Gandra-et-al/NanoLogger/README.md

NanoLogger
==========

A low-cost versatile data logging system for ecological applications

==========

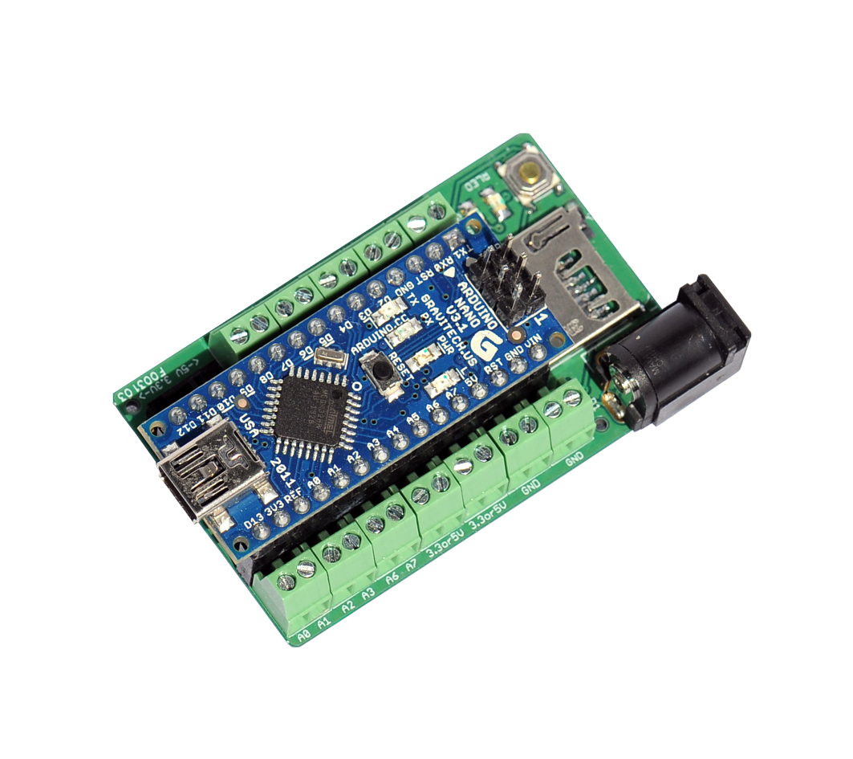
[picture p1: NanoLogger.png]
NanoLogger
