Gandra-et-al/NanoLogger/Software/Settings.txt

Rate = 1
LogDuration = 10
SleepDuration = 10
StartDate = 2014-05-31
StartTime = 16:30
FileThreshold = 10

/// INSTRUCTIONS ///
Rate in Hz, samples/second (up to 3000)
LogDuration in seconds
SleepDuration in seconds
StartDate: (yyyy-mm-dd)
StartTime: (hh:mm, 24 hours format)
FileThreshold - generate a new file after x sampling sessions
