Gandra-et-al/NanoLogger/Hardware/Schematic.pdf

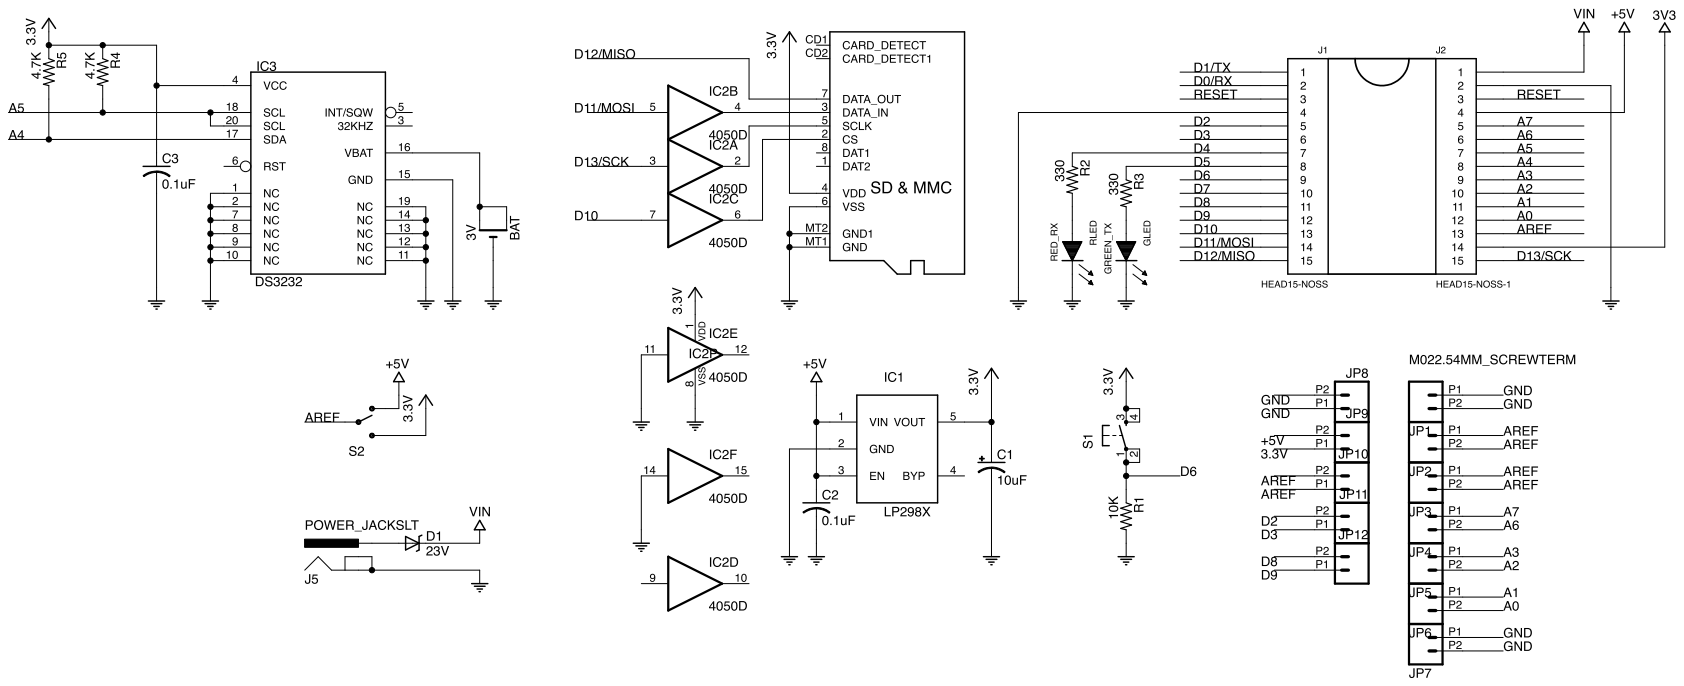
[picture p2: page 1]
