Gandra-et-al/NanoLogger/Hardware/NanoLogger_V2.brd

## EAGLE design Hardware/NanoLogger_V2.brd (2014-05-20)

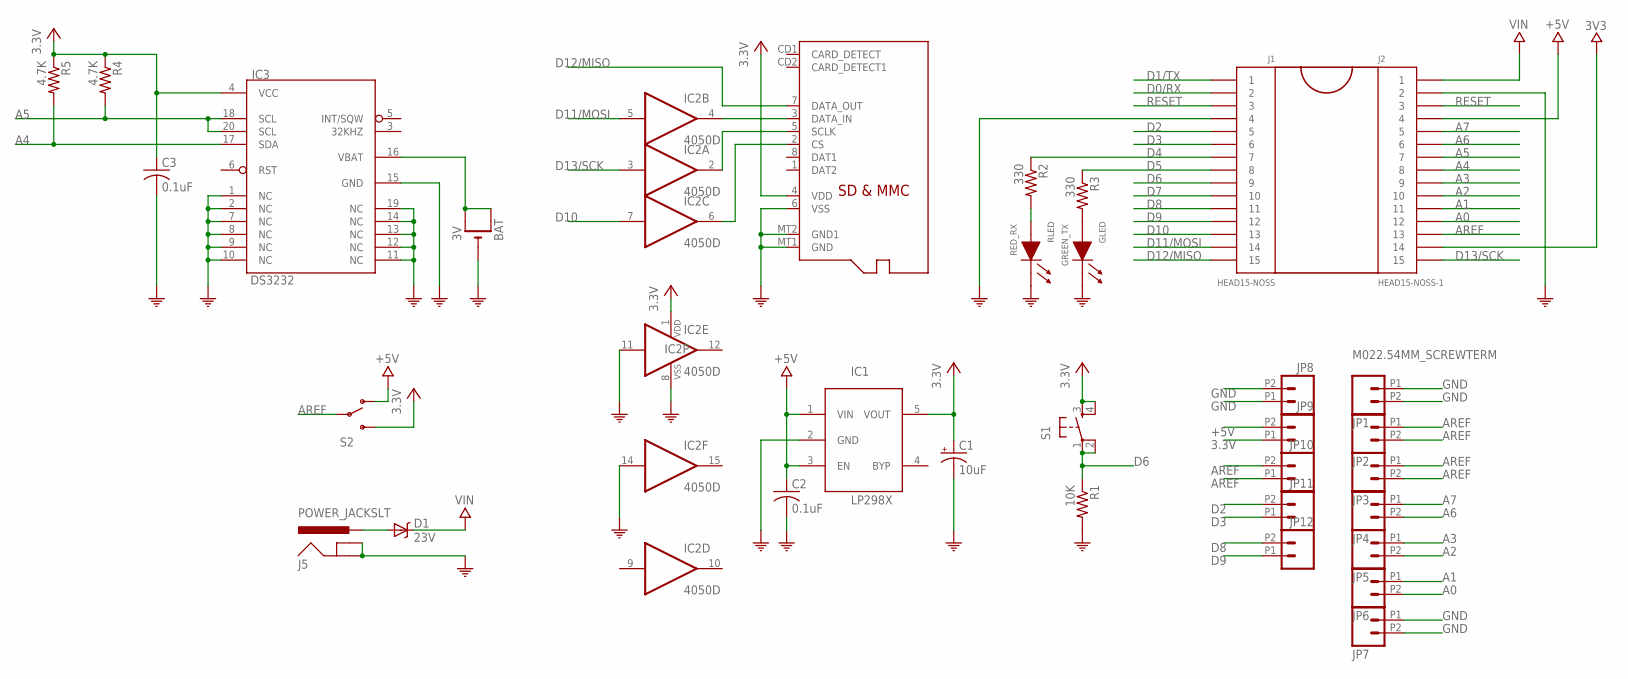
[picture p3: schematic NanoLogger_V2.sch]

Parts:
BAT: 3V; CR1220-SMD
C1: 10uF; A/3216-18R
C2, C3: 0.1uF; C0805K
D1: 23V; SOD-323
GLED: GREEN_TX; LED0805
IC1: LP298XS; SOT23-5L
IC2: 4050D; SO16
IC3: DS3232; SO20L
J1: HEAD15-NOSS
J2: HEAD15-NOSS-1
J5: POWER_JACKSLT; POWER_JACK_SLOT
JP1, JP2, JP3, JP4, JP5, JP6, JP7, JP8, JP9, JP10, JP11, JP12: M022.54MM_SCREWTERM; 1X02_2.54_SCREWTERM
R1: 10K; R0805
R2, R3: 330; R0805
R4, R5: 4.7K; R0805
RLED: RED_RX; LED0805
S1: TAC_SWITCHSMD; TACTILE_SWITCH_SMD
S2: SWITCH-SPDTPTH; SWITCH-SPDT
X1: MICROSD

Connections:
3.3V: C1.+, C3.1, IC1.5 (VOUT), IC2.1 (VDD), IC3.4 (VCC), JP9.P1 (1), R4.1, R5.1, S1.3, S1.4, S2.3 (S), X1.4 (VDD)
3V3: J2.14
+5V: C2.1, IC1.1 (VIN), IC1.3 (EN), J2.4, JP9.P2 (2), S2.1 (O)
A0: J2.12, JP6.P2 (2)
A1: J2.11, JP6.P1 (1)
A2: J2.10, JP5.P2 (2)
A3: J2.9, JP5.P1 (1)
A4: IC3.17 (SDA), J2.8, R5.2
A5: IC3.18 (SCL), IC3.20 (SCL), J2.7, R4.2
A6: J2.6, JP4.P2 (2)
A7: J2.5, JP4.P1 (1)
AREF: J2.13, JP2.P1 (1), JP2.P2 (2), JP3.P1 (1), JP3.P2 (2), JP10.P1 (1), JP10.P2 (2), S2.2
BAT_POWER: D1.2 (A), J5.PWR
D0/RX: J1.2
D1/TX: J1.1
D2: J1.5, JP11.P2 (2)
D3: J1.6, JP11.P1 (1)
D4: J1.7, R2.1
D5: J1.8, R3.1
D6: J1.9, R1.1, S1.1, S1.2
D7: J1.10
D8: J1.11, JP12.P2 (2)
D9: J1.12, JP12.P1 (1)
D10: IC2.7 (I), J1.13
D11/MOSI: IC2.5 (I), J1.14
D12/MISO: J1.15, X1.7 (DATA_OUT)
D13/SCK: IC2.3 (I), J2.15
GND: BAT.-, C1.-, C2.2, C3.2, GLED.1 (CA), IC1.2 (GND), IC2.8 (VSS), IC2.11 (I), IC2.14 (I), IC3.1 (NC), IC3.2 (NC), IC3.7 (NC), IC3.8 (NC), IC3.9 (NC), IC3.10 (NC), IC3.11 (NC), IC3.12 (NC), IC3.13 (NC), IC3.14 (NC), IC3.15 (GND), IC3.19 (NC), J1.4, J2.2, J5.GND@1 (GNDBREAK), J5.GND@2 (GND), JP1.P1 (1), JP1.P2 (2), JP7.P1 (1), JP7.P2 (2), JP8.P1 (1), JP8.P2 (2), R1.2, RLED.1 (CA), X1.6 (VSS), X1.MT1 (GND), X1.MT2 (GND1)
unnamed: IC2.2 (O), X1.5 (SCLK)
unnamed: IC2.6 (O), X1.2 (CS)
unnamed: IC2.4 (O), X1.3 (DATA_IN)
unnamed: GLED.2 (AN), R3.2
unnamed: R2.2, RLED.2 (AN)
RESET: J1.3, J2.3
VBAT: BAT.+$1 (+), BAT.+$2 (+1), IC3.16 (VBAT)
VIN: D1.1 (C), J2.1

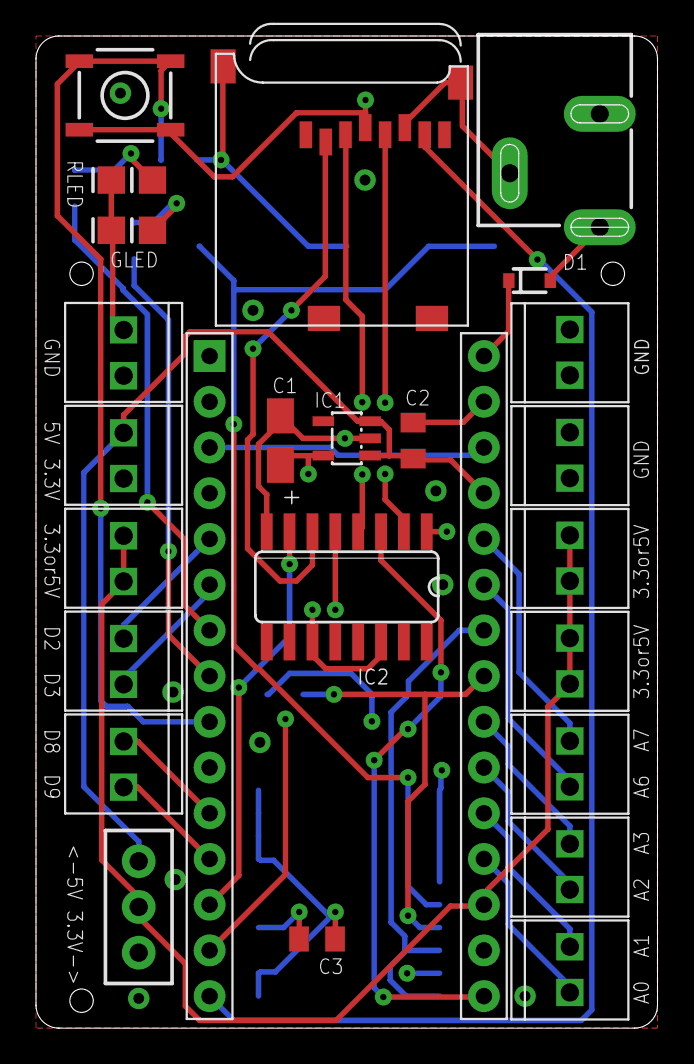
[picture p4: board NanoLogger_V2.brd from above]

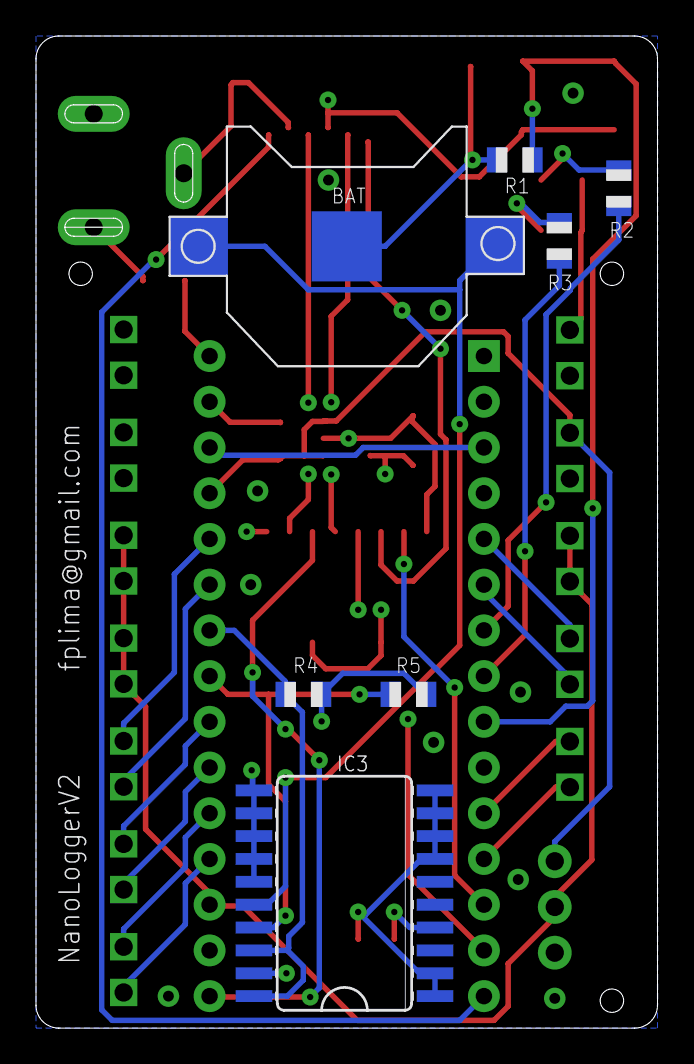
[picture p5: board NanoLogger_V2.brd from below]

Board: 4 copper layers, 34.5 x 55.1 mm, 33 parts (7 on the bottom side), 32 nets.
