Gandra-et-al/NanoLogger/Software/Arduino Libraires/NilRTOS/niltypes.h

/*
    Nil RTOS - Copyright (C) 2012 Giovanni Di Sirio.

    This file is part of Nil RTOS.

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
    You should have received a copy of the GNU General Public License
    along with this program.  If not, see <http://www.gnu.org/licenses/>.
*/

/**
 * @file    niltypes.h
 * @brief   Nil RTOS types header file.
 *
 * @addtogroup AVR_TYPES
 * @{
 */

#ifndef _NILTYPES_H_
#define _NILTYPES_H_

#include <stddef.h>
#include <stdint.h>
#include <stdbool.h>

/**
 * @name Kernel types
 * @{
 */
typedef uint8_t         tstate_t;   /**< @brief Type of a thread state.     */
typedef int16_t         msg_t;      /**< @brief Type of a message.          */
typedef uint16_t        systime_t;  /**< @brief Type of system time.        */
typedef int16_t         cnt_t;      /**< @brief Type of signed counter.     */
/** @} */

#endif /* _NILTYPES_H_ */

/** @} */
