Gandra-et-al/NanoLogger/(commit log)

2014-05-20 Eagle Files
    [NanoLogger_V2.brd, NanoLogger_V2.sch]
2014-05-20 Hardware Folder
    [NanoLogger_V2.brd, NanoLogger_V2.sch]
2014-05-21 Required Arduino Libraries
2014-05-21 Added Board Schematic
2014-05-22 Board Schematic
2014-06-09 Software modified to work with the Adafruit MAX31855 Thermocouple Amplifier board
2014-06-09 Modified Arduino IDE file to set clock speed
