Gandra-et-al/NanoLogger/(notices)

Notices in the files:
Software/Arduino Libraires/NilRTOS/niltypes.h:
Nil RTOS is free software; you can redistribute it and/or modify
it under the terms of the GNU General Public License as published by
the Free Software Foundation; either version 3 of the License, or
(at your option) any later version.
parts and their libraries:
SparkFun-Connectors: Licensing: CC v3.0 Share-Alike You are welcome to use this library for commercial purposes.
